andmatcha/nixie_bom/docs/requirements.md

# ニキシー管時計 要件定義

## 1. 目的

IN-12 ニキシー管を 6 本使用し、CAN 経由で受信した時刻を表示する卓上時計を製作する。

時計本体には RTC やバックアップ電池を搭載せず、外部の CAN ノードから配信される時刻データを表示する。

## 2. 前提とスコープ

- 表示対象は時刻表示とする。
- 表示形式は `HH:MM:SS` とする。
- 時刻は 24 時間表記とする。
- 1 桁目のゼロは表示する。例: `08:05:09`
- 数字表示には IN-12 を 6 本使用する。
- コロン表示には INS-1 を 4 個使用する。
- 時分間と分秒間に、それぞれ INS-1 を 2 個ずつ配置する。
- 入力電源は市販 AC アダプタから得られる DC 12 V とする。
- 12 V からニキシー管用の高電圧を基板上で生成する。
- 制御用 MCU は STM32 系を使用する。
- 時刻同期は CAN 経由で行う。
- RTC、GPS、Wi-Fi、単体での時刻保持機能は今回の必須範囲に含めない。

## 3. システム構成

想定する構成は以下の通り。

- DC ジャックから 12 V を入力する。
- TPS40210DGQR を中心とした昇圧回路で約 170 V のニキシー管用電源を生成する。
- STM32 が CAN フレームを受信し、表示すべき時刻を決定する。
- STM32 から SN74HC595DR などのシフトレジスタへ表示データを転送する。
- SN75468DR などのシンクドライバで IN-12 のカソードを駆動する。
- 各管のアノードを切り替える高電圧対応のアノードドライバを用意し、IN-12 はダイナミック点灯で表示する。
- INS-1 はコロン表示用として、電流制限抵抗を介して点灯制御する。
- CAN トランシーバを介して外部 CAN バスに接続する。

## 4. 表示要件

- 6 本の IN-12 で `時:分:秒` を表示する。
- 時分間と分秒間のコロンは、INS-1 を各 2 個使用して表現する。
- 秒表示までリアルタイムに更新する。
- 視認上ちらつきが分からない表示を目標とする。
- IN-12 はダイナミック点灯とし、各管の更新周期は 100 Hz 以上を目標とする。
- 桁切り替え時に短いブランキング期間を設け、ゴースト点灯を抑える。
- IN-12 の平均管電流は 1 管あたり 2 mA から 2.5 mA 程度を初期目標とする。
- ダイナミック点灯時のピーク電流は、平均管電流、デューティ比、IN-12 の許容条件を確認して決める。
- INS-1 の電流は、視認性と寿命を見ながら実機で調整できるようにする。

## 5. 電源要件

### 5.1 入力電源

- 入力電圧は DC 12 V とする。
- 入力電流容量は 1 A 以上の AC アダプタを想定する。
- DC ジャックは 2.1 mm 標準品を使用する。
- 極性はセンタープラスとする。
- 入力段には逆接続、過電流、突入電流への対策を検討する。

### 5.2 高電圧電源

- ニキシー管用の出力電圧は DC 170 V を基準とする。
- 設計上は管の個体差や輝度調整を考慮し、160 V から 180 V 程度の範囲で調整または部品定数変更できる余地を残す。
- 高電圧電源の出力電流目標は 170 V / 20 mA とする。
- 20 mA の出力電流目標には、6 本の IN-12、4 個の INS-1、輝度調整、部品ばらつき、過渡応答の余裕を含める。
- TPS40210DGQR の FB、COMP、SS、ISNS、RC 周辺部品はデータシートの設計手順に従って定数を決める。
- ISNS による過電流検出を使用し、MOSFET、インダクタ、ダイオード、出力コンデンサが異常時に過負荷にならないようにする。
- 起動時の過電圧を避けるため、ソフトスタートを有効にする。
- MCU またはハードウェアから高電圧電源を停止できる HV_ENABLE 相当の制御手段を設ける。
- 高電圧出力には放電抵抗を設け、電源断後に出力コンデンサが安全な電圧まで下がるようにする。
- 高電圧部のテストポイントには明確なシルク表記を入れる。

## 6. 点灯・駆動方式

本プロジェクトでは IN-12 にダイナミック点灯を採用する。

スタティック点灯と比べてカソード配線とドライバ数を大きく削減でき、6 桁時計として基板規模と部品点数を抑えやすいためである。

### 6.1 ダイナミック点灯の要件

- 6 本の IN-12 を順次点灯し、1 巡を十分高速に回す。
- カソード側は数字 0 から 9 の 10 系統を共通化する。
- アノード側は 6 本分を個別に切り替える。
- カソード 10 系統は SN75468DR 2 個以上、または同等の低側シンクドライバで駆動する。
- 表示駆動信号は SN74HC595DR を必要数カスケード接続して生成する。
- シフトレジスタ更新中は表示を一時的に無効化し、誤点灯を防ぐ。
- アノードドライバは 170 V 系を扱える PNP トランジスタ、Pch MOSFET、または高電圧対応の専用/ディスクリート構成で実装する。
- SN75468DR は低側シンク用途に限定し、アノードの高側スイッチには使用しない。
- 6 桁の多重化により平均 2 mA から 2.5 mA 程度の明るさを得られるよう、ピーク電流と電流制限抵抗を決める。

### 6.2 カソードプリバイアス方針

- SN75468DR の出力耐圧が 100 V 級であることを考慮し、消灯状態のカソードは約 85 V にプリバイアスする。170 V から 180 V の高電圧範囲では、無負荷 VPRE が約 85 V から 90 V になる初期定数とする。
- 点灯時は約 170 V の高電圧供給とカソード側のシンク動作により IN-12 を点灯させる。
- SN75468DR の各出力端子に印加される電圧が定格を超えないことを、回路設計と実測の両方で確認する。
- プリバイアス回路は、消灯時に誤点灯しないこと、点灯時に十分な管電流が流れること、電源断時に危険な電荷が残らないことを満たす。

### 6.3 スタティック点灯を採用しない理由

- 6 本 x 10 数字で、少なくとも 60 本分のカソード駆動出力が必要になる。
- シフトレジスタとドライバの個数、配線量、PCB 面積が増える。
- ちらつきやピーク電流設計は簡単になるが、今回の 6 桁時計では回路規模増加のデメリットが大きい。
- 表示品質や制御単純さを最優先する将来版では再検討候補とする。

### 6.4 駆動上の注意

- IN-12 と INS-1 には必ず電流制限抵抗を入れる。
- SN75468DR の COM 端子は誘導性負荷用クランプダイオードに接続されているため、ニキシー管駆動での接続先は安易に 170 V 系へ接続せず、回路方式に合わせて判断する。
- SN74HC595DR は STM32 と同じ 3.3 V ロジックで動作させる方針とし、各 IC の VCC 近傍に 0.1 uF 程度のデカップリングコンデンサを配置する。
- 未使用入力は GND または VCC に固定し、フローティングさせない。

## 7. 制御・通信要件

### 7.1 STM32

- CAN または FDCAN、SPI、タイマ、十分な GPIO、SWD を持つ STM32G0B1/G0C1/G4 系を候補とする。
- 表示更新用のタイマ、シフトレジスタ転送用の SPI または GPIO、CAN 受信用ペリフェラルを使用する。
- 高電圧電源の有効化、異常時停止、表示ブランキングを MCU から制御できるようにする。
- デバッグ用に SWD 端子を用意する。
- ファームウェア更新とデバッグがしやすいよう、リセット端子とブート設定にアクセスできるようにする。

### 7.2 CAN

- CAN 経由で現在時刻を受信し、受信した時刻を表示する。
- 時計本体は時刻の一次ソースを持たない。
- CAN は CAN 2.0B、1 Mbps、標準 ID を基本条件とする。
- 時刻フレームは 1 Hz 以上の周期で送信されるものとする。
- 時刻データは時、分、秒をバイナリで送る単純な形式とする。
- 最小構成では、DLC 3 とし、Byte 0 を時、Byte 1 を分、Byte 2 を秒とする。
- CAN 送信側が表示すべきローカル時刻に変換し、時計側は受信した時、分、秒をそのまま表示する。
- 起動直後、CAN で有効な時刻を受信するまでは表示をブランクまたは待機表示にする。
- 最終受信から 2 秒を超えたら表示をブランクする。
- CAN 途絶が長時間続く場合は、高電圧電源も停止する。初期値として 10 秒超を目安にする。
- CAN トランシーバは STM32 の I/O 電圧と CAN バス仕様に合わせて選定する。
- CAN 終端抵抗 120 ohm は、ジャンパまたは DIP スイッチで有効/無効を切り替えられるようにする。

## 8. 安全・実装要件

- 170 V 系は低電圧ロジック系から物理的に距離を取り、配線領域を分ける。
- 高電圧配線、テストポイント、出力コンデンサ周辺には警告シルクを入れる。
- ユーザーが触れる可能性のある部分に高電圧が露出しない構造にする。
- 初回基板でも高電圧部に触れられない構造を必須とする。
- 最終ケース設計は別工程に分ける。
- 高電圧部の部品は、電圧定格、電力定格、温度上昇に十分な余裕を持たせる。
- 出力コンデンサ、帰還抵抗、電流制限抵抗、プリバイアス抵抗は電圧定格と消費電力を確認する。
- CAN、12 V 入力、170 V 出力、GND、HV_ENABLE には確認しやすいテストポイントを設ける。
- 初回通電時はニキシー管を接続せず、ダミーロードで 170 V 出力、リップル、過電流保護、部品温度を確認する。

## 9. 検証要件

- 12 V 入力で高電圧出力が目標値に立ち上がることを確認する。
- 無負荷、ダミーロード、実負荷の各条件で高電圧出力が安定することを確認する。
- 170 V / 20 mA 相当の負荷で、入力電流が 12 V / 1 A の範囲に収まることを確認する。
- MOSFET、インダクタ、ダイオード、出力コンデンサ、電流制限抵抗、プリバイアス抵抗の温度上昇を確認する。
- IN-12 の平均管電流が 2 mA から 2.5 mA 程度になることを確認する。
- ダイナミック点灯で、ちらつき、ゴースト、輝度ムラが許容範囲に収まることを確認する。
- SN75468DR の出力端子電圧が、点灯時、消灯時、切り替え時の各条件で定格内に収まることを確認する。
- INS-1 の明るさが IN-12 表示と大きく乖離しないことを確認する。
- CAN 受信正常時に時刻表示が 1 秒ごとに更新されることを確認する。
- CAN 途絶 2 秒超で表示がブランクすることを確認する。
- CAN 途絶が長時間続いた場合に高電圧電源が停止することを確認する。
- 電源断後、高電圧出力が放電抵抗により安全側へ低下することを確認する。

## 10. 選定済み部品

### 10.1 電源系

| 型番 | 用途 | 要件上の扱い |
| --- | --- | --- |
| TPS40210DGQR | 昇圧コントローラ | 12 V から 170 V を生成する高電圧電源の中心部品 |
| 7447709102 | インダクタ 1 mH / 900 mA | 昇圧回路用。飽和電流、温度上昇、DCR を実負荷で確認する |
| STD10N60M2 | 600 V Nch MOSFET | 昇圧スイッチ用。VDS、ID、発熱、ゲート駆動条件を確認する |
| STTH2R06U | 600 V / 2 A ダイオード | 昇圧整流用。逆回復、順方向損失、発熱、電圧定格を確認する |
| GRM55DR72E105KW01L | 1 uF / 250 V セラミックコンデンサ | 高電圧出力平滑用。DC バイアス、リップル、並列数を確認する |
| GRM188R72A104KA35D | 0.1 uF / 100 V セラミックコンデンサ | 制御・補助回路用。配置と定格を回路ごとに確認する |
| GCM188R71H102KA37D | 1000 pF / 50 V セラミックコンデンサ | 補償・フィルタ用途候補。使用箇所に応じて定数を確定する |
| ERJ-8BSFR10V | 0.1 ohm / 1% / 1/2 W 抵抗 | 電流検出用途候補。TPS40210 の電流制限条件と整合を確認する |

### 10.2 制御・表示駆動系

| 型番 | 用途 | 要件上の扱い |
| --- | --- | --- |
| STM32G0B1CBT6 | 制御 MCU | CAN 受信、表示更新、HV_ENABLE、ブランキング、SWD デバッグを担当する |
| AP63203QWU-7 | 3.3 V 降圧レギュレータ | 12 V から MCU、CAN、ロジック用の 3.3 V を生成する |
| 74439346068 | 6.8 uH インダクタ | AP63203QWU-7 の降圧回路用 |
| TCAN334GDR | CAN トランシーバ | 3.3 V 単電源の CAN 物理層。1 Mbps の CAN 2.0B で使用する |
| ESD2CAN24DBZRQ1 | CAN ESD 保護 | CANH/CANL の外部接続保護用 |
| ECS-80-12-33-JGN-TR | 8 MHz 水晶振動子 | CAN ビットタイミングの安定化を目的に MCU の HSE として使用する |
| SN75468DR | 7ch Darlington シンクドライバ | 2 個使用し、10 本の IN-12 カソードを駆動する。プリバイアス方式で出力端子電圧を 100 V 級に抑える |
| SN74HC595DR | 8bit シフトレジスタ | 3 個使用し、カソード、アノード、INS-1 制御信号を生成する |
| MMBTA92-7-F | 300 V PNP トランジスタ | IN-12 アノード高側スイッチ用 |
| MMBTA42-7-F | 300 V NPN トランジスタ | IN-12 アノードドライバのレベルシフト、および INS-1 低側スイッチ用 |
| INS-1 | ネオンランプ | コロン表示用。時分間と分秒間に 2 個ずつ、合計 4 個使用する |

## 11. 未確定要件

現時点で、要件としての未確定項目はない。

以下は要件ではなく、詳細設計または部品選定で確定する項目とする。

- STM32G0B1CBT6 の具体的なピン割り当て
- SN74HC595DR のビット割り当て
- IN-12、INS-1、プリバイアス回路の抵抗値の実機調整
- TPS40210DGQR 周辺の帰還、補償、ソフトスタート、電流検出、発振周波数設定の定数
- PCB 上の高電圧クリアランス、テストポイント配置、警告シルク
- 最終ケース構造
