andmatcha/nixie_bom/selection_criteria.md

# 部品選定基準

## プロジェクト概要

- プロジェクト名: nixie_bom
- 用途: IN-12 ニキシー管 6 本と INS-1 4 個を使う CAN 同期式ニキシー管時計
- 入力電源: DC 12 V、1 A 以上の AC アダプタを想定
- 主要機能: 12 V から約 170 V を生成し、STM32 が CAN 経由で受信した時刻を HH:MM:SS で表示する
- 詳細要件の参照先: `docs/requirements.md`

## 必須条件

- Digi-Key で通常在庫かつ即時入手可能な部品を優先する。
- アクティブ品を採用し、EOL、Obsolete、Discontinued、NCNR、Marketplace のみの部品は避ける。
- RoHS 対応品を優先する。
- データシートが取得できる部品を採用する。
- 高電圧系は 170 V から 180 V の動作範囲と異常時余裕を考慮し、電圧定格と電力定格に十分な余裕を持たせる。
- 3.3 V ロジック系は STM32、CAN トランシーバ、SN74HC595DR と整合する部品を選ぶ。
- CAN は CAN 2.0B、1 Mbps を前提にする。
- CAN 終端、ESD 保護、SWD、リセット、HV_ENABLE、ブランキング制御に必要な部品を含める。

## 推奨条件

- コンデンサは Murata 品を優先する。
- 抵抗は Panasonic 品を優先する。
- 0603、0805、1206、1210 など手実装と基板面積のバランスが取りやすいパッケージを優先する。
- Digi-Key のカットテープ品で少量試作しやすい部品を優先する。
- 代替品選定時は元の値、定格、温度特性、パッケージを維持する。

## 評価観点

- 12 V 入力、170 V / 20 mA 高電圧出力、6 桁ダイナミック点灯で電気的余裕があること。
- MOSFET、インダクタ、ダイオード、電流検出抵抗、放電抵抗、プリバイアス抵抗の発熱余裕があること。
- SN75468DR の出力端子電圧が 100 V 級の定格内に収まるプリバイアス構成に合うこと。
- CAN 1 Mbps で通信品質を確保できること。
- 試作時に入手しやすく、将来の置き換え候補も見つけやすいこと。

## 除外条件

- EOL、Obsolete、Discontinued、NCNR の部品。
- Marketplace のみ、在庫 0、最小注文数量が試作規模に対して過大な部品。
- データシートがない部品。
- 高電圧部で電圧定格または電力定格の余裕が不足する部品。
- 要件上の用途と矛盾する部品。例: SN75468DR を高側アノードスイッチとして使う構成。

## BOM運用メモ

- DB 管理 BOM は `data/digikey/parts.sqlite3` の `bom_items` を正とする。
- `bom/bom.csv` は `dktools` が DB から出力する確認用スナップショットとして扱う。
- 既存の統合 BOM 入力は `bom/nixie_clock_integrated_digikey_bom_active.csv` を参照する。
- Digi-Key アップロード用 CSV は必要時に `dktools bom export-digikey` で生成する。
- 価格再取得と部品ストア更新は必要時に `dktools bom price` と `dktools store update --from-bom` で行う。

## 未確定事項

- STM32 の具体的なピン割り当て。
- SN74HC595DR のビット割り当て。
- IN-12、INS-1、プリバイアス回路の抵抗値。
- TPS40210DGQR 周辺の帰還、補償、ソフトスタート、電流検出、発振周波数設定の最終定数。
- PCB 上の高電圧クリアランス、テストポイント配置、警告シルク。
- 最終ケース構造。
