andmatcha/nixie_bom/docs/kicad_library_gaps.md

# KiCad ライブラリ未確定・要レビュー部品

標準ライブラリまたは生成ライブラリで回路図への配置は済ませたが、下記はメーカー専用品、近似フットプリント、またはピン/機械寸法の確認が必要な部品である。

| Ref | MPN | Selected Symbol | Selected Footprint | Issue | Next Action |
| --- | --- | --- | --- | --- | --- |
| - | - | - | - | 未確定または取得不能な部品はなし | - |
