andmatcha/nixie_bom/docs/digikey_availability.md

# Digi-Key 可用性チェック

`bom/nixie_clock_integrated_digikey_bom_active.csv` の各明細について、Digi-Key 上でアクティブ、在庫あり、即時入手可能かを確認した。

| 項目 | 値 |
| --- | ---: |
| 対象明細数 | 46 |
| 即時入手可能 | 46 |
| 要確認 | 0 |
| 判定 | OK |

確認日時: 2026-06-22 21:01:42 JST
出力 CSV: `bom/nixie_clock_active_digikey_availability.csv`

## 要確認明細

| Reference Designator | Manufacturer Part Number | Status | Quantity Available | 理由 |
| --- | --- | --- | ---: | --- |
| なし | なし | なし | なし | なし |
