andmatcha/nixie_bom/docs/digikey_replacements.md

# Digi-Key 代替品選定

在庫 0、Digi-Key ステータスが新規設計向けに不適合、または安全余裕改善のため置換した BOM 明細について、代替品を選定した。

出力 BOM: `bom/nixie_clock_integrated_digikey_bom_active.csv`

| Reference Designator | 旧型番 | 新型番 | 新 Digi-Key 品番 | Status | 在庫 | 主な仕様 | 理由 |
| --- | --- | --- | --- | --- | ---: | --- | --- |
| CRC1 | GRM1885C1H101JA01D | GCM1885C1H101JA16D | 490-4767-1-ND | アクティブ | 2080401 | 静電容量: 100 pF; 許容誤差: ±5%; 電圧 - 定格: 50V; 温度係数: C0G、NP0; パッケージ/ケース: 0603（1608メートル法） | 旧品はDigi-Keyステータスが新規設計向けに不適合。CRCは100pF、50V、C0G/NP0、0603を維持し、アクティブかつ在庫あり。 |
| CIFLT1 | GCM1885C1H101JA16D | GCM1885C1H471JA16D | 490-4965-1-ND | アクティブ | 28260 | 静電容量: 470 pF; 許容誤差: ±5%; 電圧 - 定格: 50V; 温度係数: C0G、NP0; パッケージ/ケース: 0603（1608メートル法） | TPS40210のISNSフィルタ時定数をデータシート目安へ近づけるため、100pFから470pFへ変更。 |
| D1 | MURS160-13-F | STTH2R06U | 497-3776-1-ND | アクティブ | 16670 | 電圧 - DC逆方向: 600 V; 電流 - 平均整流: 2A; 逆回復時間: 50 ns; パッケージ/ケース: DO-214AA、SMB | 同じ600 V/SMB/trr 50 nsを維持しつつ、平均整流電流を1 Aから2 Aへ増やして安全余裕を改善する。 |
| CHF1 | GCM1885C1H470JA16D | GCM1885C1H470GA16J | 490-GCM1885C1H470GA16JCT-ND | アクティブ | 7433 | 静電容量: 47 pF; 許容誤差: ±2%; 電圧 - 定格: 50V; 温度係数: C0G、NP0; パッケージ/ケース: 0603（1608メートル法） | 旧品はDigi-Keyステータスが新規設計向けに不適合。47pF、50V、C0G/NP0、0603を維持し、許容差はより厳しく、アクティブかつ在庫あり。 |
| RIFLT1 REN1 | ERJ-3EKF1001V | ERJ-3GEYJ102V | P1.0KGCT-ND | アクティブ | 26489 | 抵抗: 1 kOhms; 許容誤差: ±5%; 温度係数: ±200ppm/°C; パッケージ/ケース: 0603（1608メートル法）; 電力（ワット）: 0.1W、1/10W; 組成: 厚膜 | 旧品はDigi-Key在庫0。今回の抵抗メーカー指定に合わせ、ISNSフィルタ/DIS-EN直列用途で許容できるPanasonic在庫品を採用。 |
| C3V3IN1 C3V3IN2 | GRM31CR71H475KA12L | GRJ31CR71H475KE11K | 490-GRJ31CR71H475KE11KCT-ND | アクティブ | 5980 | 静電容量: 4.7 µF; 許容誤差: ±10%; 電圧 - 定格: 50V; 温度係数: X7R; パッケージ/ケース: 1206（3216メートル法） | 旧品はDigi-Key在庫0。4.7uF、50V、X7R、1206を維持し、アクティブかつ在庫あり。 |
| C3V3OUT1 C3V3OUT2 | GRT31CR61E226ME01L | GRM31CC81E226KE11L | 490-14468-1-ND | アクティブ | 58999 | 静電容量: 22 µF; 許容誤差: ±10%; 電圧 - 定格: 25V; 温度係数: X6S; パッケージ/ケース: 1206（3216メートル法） | 旧品はDigi-Keyステータスが新規設計向けに不適合。22uF、25V、1206を維持し、今回のコンデンサメーカー指定に合わせてMurata在庫品を採用。 |
| CY1 CY2 | GRM1885C1H180JA01D | GCM1885C1H180FA16D | 490-GCM1885C1H180FA16DCT-ND | アクティブ | 1302 | 静電容量: 18 pF; 許容誤差: ±1%; 電圧 - 定格: 50V; 温度係数: C0G、NP0; パッケージ/ケース: 0603（1608メートル法） | 旧品はDigi-Keyステータスが新規設計向けに不適合。18pF、50V、C0G/NP0、0603を維持し、許容差はより厳しく、アクティブかつ在庫あり。 |
| RAHOFF1A-RAHOFF6B | ERJ-6ENF1004V 単体/桁 | ERJ-6ENF4993V x 2/桁 | P499KCCT-ND | アクティブ | 197025 | 抵抗: 499 kOhms; 許容誤差: ±1%; 電力: 0.125W; パッケージ/ケース: 0805（2012メートル法） | PNP オン時に 170 V 系の電位差を受けるため、1 MOhm 単体ではなく 499 kOhm x 2 直列として抵抗 1 本あたりの印加電圧を約 85 V へ分散する。 |
| RPREH1 | ERJ-6ENF1503V | ERJ-6ENF1803V | P180KCCT-ND | アクティブ | 29682 | 抵抗: 180 kOhms; 許容誤差: ±1%; 電力: 0.125W; パッケージ/ケース: 0805（2012メートル法） | VPRE を 170 V 時約 85.0 V、180 V 時約 90.0 V へ下げ、SN75468 の 100 V 出力耐圧に対する静的余裕を増やす。 |

## 選定ルール

- 元の値、定格、サイズ、温度特性を維持することを優先した。
- 今回の指定に合わせ、コンデンサはMurata、抵抗はPanasonicを優先した。
- 選定後に Digi-Key ProductDetails を再取得し、`アクティブ`、必要数量以上の在庫、即時入手可能を確認した。
