andmatcha/nixie_bom/docs/tps40210_datasheet_summary.md

# データシート要約: Texas Instruments TPS40210DGQR

## 1. 部品概要

| 項目 | 内容 |
| --- | --- |
| メーカー | Texas Instruments |
| 型番 | TPS40210DGQR |
| 部品カテゴリ | 電源IC・DC/DCコントローラ |
| 主用途 | 非同期昇圧、フライバック、SEPIC、LEDドライバ向けの電流モード低側Nch MOSFETコントローラ |
| このプロジェクトでの役割 | DC 12 VからIN-12/INS-1用の約170 V / 20 mAを生成する昇圧電源コントローラ |
| パッケージ | HVSSOP, DGQ, 10ピン, PowerPAD |
| データシート版・日付 | SLUS772G, March 2008, Revised June 2020 |
| 参照PDF | docs/tps40210.pdf |

## 2. 結論サマリ

- 採用可否: 条件付きで採用可能
- 主な理由: 12 V入力は推奨VDD範囲内で、外付けMOSFET方式の昇圧構成に適合する。170 V出力はIC端子に直接印加せず、外付けMOSFET、ダイオード、出力コンデンサ、帰還抵抗の定格で成立させる設計であれば使用できる。
- 設計上もっとも重要な制約: 高昇圧比による高デューティ動作、最小オフ時間、電流検出抵抗と内部スロープ補償の上限、起動時の出力コンデンサ充電電流、標準昇圧回路では出力短絡時に入力から出力へ電流経路が残ること。
- 実機で必ず確認する項目: 10.8 V入力時の起動、170 V / 20 mA負荷時のSW波形、ISNS波形、出力リップル、COMP安定性、起動時過電流、CAN途絶時DIS/EN停止、電源断後の放電、MOSFET/インダクタ/ダイオード温度。
- 未確認リスク: 外付け部品それぞれの詳細データシートに基づく熱、飽和、逆回復、DCバイアス、抵抗電圧定格は別途確認が必要。

## 3. 重要仕様一覧

| 項目 | 値 | Min/Typ/Max | 条件 | 参照箇所 | 設計上の意味 |
| --- | --- | --- | --- | --- | --- |
| VDD推奨動作範囲 | 4.5 Vから52 V | Min/Max | Recommended Operating Conditions | p.4, 6.3 | 12 V入力駆動は範囲内。170 V出力へVDDを接続してはいけない。 |
| VDD絶対最大定格 | -0.3 Vから52 V | Min/Max | Absolute Maximum Ratings | p.4, 6.1 | VDDは52 Vを超えない設計が必須。 |
| RC, SS, FB, DIS/EN絶対最大定格 | -0.3 Vから10 V | Min/Max | Absolute Maximum Ratings | p.4, 6.1 | FB分圧、DIS/EN制御、RC/SS部品は低電圧ノードとして扱う。 |
| ISNS絶対最大定格 | -0.3 Vから8 V | Min/Max | Absolute Maximum Ratings | p.4, 6.1 | 電流検出ノードのスパイクを抑える。 |
| COMP, BP, GDRV絶対最大定格 | -0.3 Vから9 V | Min/Max | Absolute Maximum Ratings | p.4, 6.1 | ゲート駆動はBP由来の約8 V系。 |
| 動作ジャンクション温度 | -40 degCから125 degC | Min/Max | Recommended Operating Conditions | p.4, 6.3 | 実機でIC周辺温度を確認する。 |
| HVSSOP熱抵抗RthetaJA | 67.2 degC/W | Typ相当 | Thermal Information, TPS40210 HVSSOP | p.4, 6.4 | BP外部負荷やゲート駆動損失を増やしすぎない。 |
| FB基準電圧, TPS40210 | 686 mV / 700 mV / 714 mV | Min/Typ/Max | 4.5 V <= VDD <= 52 V, -40 degC <= TJ <= 125 degC | p.5, 6.5 | 出力設定と出力電圧許容範囲の基準。 |
| UVLOオンしきい値 | 4.00 V / 4.25 V / 4.50 V | Min/Typ/Max | VDD rising | p.5, 6.5 | 12 V入力では十分余裕あり。 |
| UVLOヒステリシス | 140 mV / 195 mV / 240 mV | Min/Typ/Max | VDD | p.5, 6.5 | 低入力時の起動停止挙動に影響。 |
| 発振周波数範囲 | 35 kHzから1000 kHz | Min/Max | Oscillator | p.5, 6.5 | 約168 kHz設定は範囲内。 |
| 推奨RC範囲 | CT 68 pFから120 pF、RT 100 kOhmから1 MOhm | 推奨 | Setting the Oscillator Frequency | p.16, 7.3.5 | CRC=100 pF、RRC=1 MOhmは範囲内だがRRCは上限値。 |
| 最小オン時間 | 275 ns typ, 400 ns max | Typ/Max | VDD=12 V | p.5, 6.5 | 今回のオン時間約5.5 usに対して十分余裕。 |
| 最小オフ時間 | 170 ns typ, 200 ns max | Typ/Max | PWM | p.5, 6.5 | 10.8 V入力時のオフ時間約376 nsで余裕あり。 |
| 過電流検出しきい値 | 120 mV / 150 mV / 180 mV | Min/Typ/Max | 4.5 V <= VDD < 52 V, -40 degC <= TJ <= 125 degC | p.5, 6.5 | RSNSとインダクタ飽和電流の組み合わせ確認が必要。 |
| Leading edge blanking | 75 ns | Typ | Overcurrent protection | p.5, 6.5 | ISNSスパイクの短時間マスク。 |
| 電流センスアンプゲイン | 4.2 V/V / 5.6 V/V / 7.2 V/V | Min/Typ/Max | Current Sense Amplifier | p.5-p.6, 6.5 | スロープ補償計算に関係。 |
| GDRVソース電流 | 375 mA / 400 mA | Min/Typ | VGDRV=4 V, TJ=25 degC | p.6, 6.5 | 外付けMOSFETのゲート電荷とスイッチング損失を確認する。 |
| GDRVシンク電流 | 330 mA / 400 mA | Min/Typ | VGDRV=4 V, TJ=25 degC | p.6, 6.5 | ゲート抵抗とターンオフ速度に関係。 |
| BP電圧 | 7 V / 8 V / 9 V | Min/Typ/Max | 0 mA < IBP < 15 mA | p.6, 6.5 | BPには1 uFを近接配置する。外部負荷を安易に接続しない。 |
| DIS/ENしきい値 | 0.7 Vから1.3 V | Min/Max | Turn-on voltage | p.6, 6.5 | ピンを高くすると停止、低いまたは未接続で有効。3.3 V MCUで停止制御可能。 |
| DIS内部プルダウン | 0.7 MOhm / 1.1 MOhm / 1.5 MOhm | Min/Typ/Max | DIS/EN | p.6, 6.5 | 未接続では有効になる。安全停止が必要なら外部プルダウン/制御論理を明確化する。 |
| ESD耐量 | HBM +/-1500 V, CDM +/-1500 V | Value | ESD Ratings | p.4, 6.2 | 通常のESD管理を前提に実装する。 |
| TPS40210DGQR状態 | Active, Production, RoHS Yes, MSL Level-1-260C-UNLIM | 表記値 | Mechanical, Packaging, and Orderable Information | p.45, Orderable table, 9-Nov-2025 | ローカルPDF上ではTPS40210DGQRは量産中扱い。 |

## 4. カテゴリ別確認事項

### 4.1 電源IC・DC/DCコントローラ

- 入力電圧範囲: データシート推奨はVDD 4.5 Vから52 V。今回の12 V nominal、10.8 Vから13.2 V確認範囲は適合する。
- FB基準電圧: TPS40210は700 mV typ、全温度範囲で686 mVから714 mV。
- スイッチング周波数: 35 kHzから1000 kHz。外付けRT/CTで設定する。
- 最小オン/オフ時間: VDD=12 Vで最小オン時間400 ns max、最小オフ時間200 ns max。
- 電流検出: ISNSが過電流しきい値を超えるとヒカップ動作に入り、SSコンデンサで再試行時間が決まる。
- ゲートドライブ: 内蔵400 mA級低側ゲートドライバ。Nch MOSFETのソースをGND基準で使う構成に適合する。
- BPレギュレータ: 約8 V出力。1 uFバイパスが必須。外部負荷を接続する場合はIC損失を確認する。
- DIS/EN: 高レベルでシャットダウン、低レベルまたは未接続で有効。シャットダウン時はBPレギュレータも停止する。
- レイアウト: VDD/BP/ISNS/RC/FB/COMP/SS周辺をIC近傍に置き、SWノードと大電流ループを小さくする。
- 異常時: 標準昇圧トポロジでは出力短絡時に入力からインダクタとダイオード経由で出力へ電流が流れるため、必要に応じてヒューズなど二次保護が必要。

## 5. ピン・端子情報

| ピン名 | 役割 | 推奨接続 | 禁止・注意事項 | 参照箇所 |
| --- | --- | --- | --- | --- |
| RC | 発振周波数設定 | RCからVDDへ抵抗、RCからGNDへコンデンサ | 100 kOhmから1 MOhm、68 pFから120 pFが扱いやすい。同期時以外は不要なノイズを入れない。 | p.3, Pin Functions; p.16, 7.3.5 |
| SS | ソフトスタート、過電流再試行タイマ | SSからGNDへコンデンサ | 起動時のCOUT充電電流が過電流しきい値を超えないようにする。 | p.3, Pin Functions; p.12-p.14, 7.3.1 |
| DIS/EN | シャットダウン入力 | MCU制御、未使用時はGND推奨 | 高レベルで停止、未接続では内部プルダウンにより有効。HV_ENABLEの論理を取り違えない。 | p.3, Pin Functions; p.15, 7.3.3; p.24, 7.4.2 |
| COMP | エラーアンプ出力 | COMP-FB間に補償ネットワーク | SW/ISNSの高dv/dtノイズから離す。 | p.3, Pin Functions; p.21-p.23, 7.3.10 |
| FB | 帰還入力 | VOUTからGNDへの分圧中点 | FB端子自体は10 V abs max。170 Vは上側抵抗列だけに印加する。 | p.3, Pin Functions; p.29-p.31, 8.2.1.2.10 |
| GND | ICグラウンド | 電流検出抵抗のGND側と低ノイズに接続 | 大電流ループの戻りと小信号GNDの取り回しに注意。 | p.3, Pin Functions; p.37, 10.1 |
| ISNS | 電流検出入力 | MOSFETソース電流検出抵抗からRIFLT/CIFLT経由で接続 | 過電流しきい値は120 mVから180 mV。フィルタ部品はISNS/GND近傍。 | p.3, Pin Functions; p.18-p.20, 7.3.7から7.3.9 |
| GDRV | 外付けNch MOSFETゲート駆動 | ゲート抵抗を介してMOSFETゲートへ | トレースと戻り経路の寄生を小さくする。 | p.3, Pin Functions; p.23, 7.3.11; p.37, 10.1 |
| BP | 内部レギュレータ出力 | BP-GND間に1 uFを近接配置 | 外部負荷を接続する場合はTPS40210の熱を確認。シャットダウン時は停止。 | p.3, Pin Functions; p.14-p.15, 7.3.2 |
| VDD | IC入力電源 | 12 V入力へ接続し、近接バイパスを置く | VDD abs maxは52 V。今回の170 V出力へ接続不可。 | p.3, Pin Functions; p.4, 6.1; p.36, 9 |

## 6. 外付け部品・周辺回路

| 部品 | 接続先 | 役割 | 推奨値・式 | 今回の設計での扱い |
| --- | --- | --- | --- | --- |
| RRC, CRC | RC, VDD, GND | 発振周波数設定 | Eq.14。CTは68 pFから120 pF、RTは100 kOhmから1 MOhm推奨。 | 100 pF + 1.00 MOhmで約168 kHz。OK。ただしRRCは推奨上限。 |
| CSS | SS-GND | ソフトスタート、過電流再試行タイマ | Eq.1からEq.6。VDD > 8 Vでは例としてCSS = 20 x TSS x 10^-6。 | 1 uFへ増量済み。20 mA負荷付き起動を見込む。 |
| RIFLT, CIFLT | 電流検出抵抗からISNS | ISNSノイズフィルタ | RIFLTは1 kOhmから5 kOhm程度、RIFLT x CIFLT = 0.1 x tON。 | 1 kOhm + 470 pFへ変更済み。今回条件の目安約0.55 usに対して0.47 us。 |
| RSNS | MOSFETソース-GND | 電流モード制御、過電流検出 | Eq.15, Eq.16, Eq.19。過電流とスロープ補償の両方で上限を決める。 | L1維持前提で0.15 Ohmへ変更済み。Eq.19の80 %目安に収めつつ過電流点を下げる。 |
| FB分圧抵抗 | VOUT-FB-GND | 出力電圧設定 | 上側抵抗は10 kOhmから100 kOhmの範囲が目安。 | 上側合計100 kOhm、下側412 Ohmで約170.6 V。OK。 |
| COMP補償 | COMP-FB | ループ補償 | Eq.22からEq.29。実測またはWEBENCH/Spiceで確認推奨。 | 68 kOhm, 2200 pF, 47 pFは初期値として妥当。実機で要調整。 |
| ゲート抵抗 | GDRV-MOSFETゲート | リンギング、ジッタ、EMI低減 | Eq.30, RG = 105 / QG。QGは8 V VGS時のnC。 | 10.2 Ohmは保守的。MOSFETのQGと発熱で要確認。 |
| BPバイパス | BP-GND | 内部8 Vレギュレータ安定化 | 1 uF必須。 | CBP1=1 uFでOK。IC近傍に配置する。 |
| VDDバイパス | VDD-GND | 入力高周波デカップリング | 近接配置。入力源が離れる場合は追加バルク容量が必要になり得る。 | CVDD1=1 uFはOK。12 V入力にはCINB1/CINB2として22 uF x2を追加済み。 |
| 出力短絡保護 | 入力または高電圧出力 | 昇圧回路の短絡保護 | 標準昇圧では入力から出力へ電流経路が残る。 | 初期試作では12 V入力側にFHV1を追加し、将来eFuseやHV側保護を検討する。 |

## 7. 設計式と今回条件への適用

### 7.1 デューティ比と最小オフ時間

- 式: CCMでは D = 1 - VIN / (VOUT + VD)
- データシート上の制約: TPS40210の最小オフ時間は200 ns max、最小オン時間は400 ns max。
- 今回の設計条件: VIN = 10.8 Vから13.2 V、VOUT = 170 V、VD = 1 V、fSW = 約167.9 kHz。
- 計算結果:

| VIN | Duty | tON | tOFF |
| ---: | ---: | ---: | ---: |
| 10.8 V | 93.68 % | 5.58 us | 376 ns |
| 12.0 V | 92.98 % | 5.54 us | 418 ns |
| 13.2 V | 92.28 % | 5.50 us | 460 ns |

- 設計上の注意: 最悪側の10.8 V入力でもtOFFは200 ns maxを上回る。周波数を大きく上げると余裕が減る。

### 7.2 発振周波数

- 式: データシートEq.14でRTをfSWとCTから求める。
- 変数: RTはkOhm、fSWはkHz、CTはpF。
- 今回の設計条件: CRC = 100 pF、RRC = 1.00 MOhm。
- 計算結果: fSW = 約167.9 kHz。
- 設計上の注意: RRCはデータシート推奨範囲の上限。許容差と温度で周波数は変動するが、最小オフ時間にはまだ余裕がある。

### 7.3 インダクタ電流

- 式: IRIPPLE = VIN x D / (L x fSW)、ILavg = IOUT / (1 - D)、ILpeak = ILavg + IRIPPLE / 2。
- 今回の設計条件: L = 1 mH、IOUT = 20 mA。
- 計算結果:

| VIN | IRIPPLE | ILavg | ILpeak | ILrms | IOUT(crit) |
| ---: | ---: | ---: | ---: | ---: | ---: |
| 10.8 V | 60 mA p-p | 317 mA | 347 mA | 317 mA | 1.9 mA |
| 12.0 V | 66 mA p-p | 285 mA | 318 mA | 286 mA | 2.3 mA |
| 13.2 V | 73 mA p-p | 259 mA | 295 mA | 260 mA | 2.8 mA |

- 設計上の注意: 20 mA負荷ではCCM。通常動作電流に対してL1の900 mA/1 A級定格は余裕があるが、過電流しきい値まで含めると別途確認が必要。

### 7.4 電流検出抵抗と過電流

- 式: CCMではデータシートEq.16。スロープ補償上限はEq.19。
- データシート上の制約: VISNS(oc) = 120 mV min, 150 mV typ, 180 mV max。高デューティCCMではRISNSをEq.19の80 %以下にすることが開始点として推奨される。
- 今回の設計条件: L1は7447709102を維持し、RSNS = 0.15 Ohm、L = 1 mH、fSW = 約167.9 kHz。
- 計算結果:

| 項目 | 計算値 |
| --- | ---: |
| VIN=10.8 VでのRISNS(max), Eq.19 | 0.189 Ohm |
| 上記の80 % | 0.151 Ohm |
| 採用RSNS | 0.150 Ohm |
| VISNS=120 mV時の概算ピーク検出電流 | 0.80 A |
| VISNS=150 mV時の概算ピーク検出電流 | 1.00 A |
| VISNS=180 mV時の概算ピーク検出電流 | 1.20 A |
| VIN=10.8 V時の出力過電流目安 | 約49 mA / 61 mA / 74 mA |

- 設計上の注意: 0.15 OhmはEq.19の80 %目安にほぼ一致する。通常動作ピーク約0.35 Aに対しては余裕があり、20 mA負荷の起動条件にも余裕を作れる。一方、VISNS最大側ではピーク検出電流が1.2 A相当となり、L1のIsat 1 Aを超え得るため、実機波形と入力側ヒューズの時間電流特性を確認する。

### 7.5 ISNSフィルタ

- 式: tON = D / fSW、RIFLT x CIFLT = 0.1 x tON。
- 今回の設計条件: RIFLT = 1 kOhm、CIFLT = 470 pF。
- 計算結果: tONは約5.5 us、推奨時定数は約0.55 us。採用値は1 kOhm x 470 pF = 0.47 us。
- 設計上の注意: データシート式の目安に近づいたため、100 pF時よりISNSスパイク耐性が上がる。電流制限応答を過度に遅らせないため、SW波形とISNS波形で誤検出と遅延を確認する。

### 7.6 ソフトスタート

- 式: データシートEq.1。VDD > 8 Vの設計例ではCSS = 20 x TSS x 10^-6。
- 今回の設計条件: CSS = 1 uF、BP = 約8 V。
- 計算結果: RSS(chg)の範囲を含めるとtSSは約32 msから60 ms。typ近傍では約43 ms。
- 設計上の注意: COUT = 3 uF nominalを170 Vまで充電する電流は最短tSS側でも約16 mA程度となる。起動中に20 mA負荷も同時にかかる条件では合計約36 mAとなり、RSNS = 0.15 OhmのVIN=10.8 V最小側出力過電流目安約49 mAを下回る。実際はMLCC実効容量、補償応答、負荷の非線形性で変わるため、20 mA負荷付き起動は実測確認する。

### 7.7 出力コンデンサ

- 式: データシート設計例のEq.45では COUT = 8 x IOUT x D / (VOUT(ripple) x fSW)。
- 今回の設計条件: IOUT = 20 mA、Dmax = 93.68 %、fSW = 約167.9 kHz。
- 計算結果: 1 Vリップル目標なら約0.89 uF、0.5 Vリップル目標なら約1.79 uF。
- 設計上の注意: COUT 1 uF / 250 V x 3はnominalでは十分。ただしX7R MLCCは170 V DCバイアスで実効容量が低下するため、実機リップル測定またはMurata特性確認が必要。

### 7.8 入力コンデンサ

- 式: データシート設計例のEq.47では CIN > IRIPPLE / (4 x VIN(ripple) x fSW)。
- 今回の設計条件: IRIPPLE最大約73 mA p-p。
- 計算結果: VINリップル60 mV目標では約1.5 uF以上。
- 採用値: CIN 10 uF x2に加え、入力バルクとしてCINB 22 uF x2を追加する。
- 設計上の注意: 容量計算上はCIN 10 uF x2だけでも足りるが、データシート9章は入力源が数インチ以上離れる場合に追加バルク容量が必要になり得るとしている。ACアダプタ入力と配線インピーダンスを見込み、Murata MLCCの22 uF x2を追加する。実容量はDCバイアスで低下するため、起動時VINリップルを実測する。

### 7.9 FB分圧

- 式: VOUT = VFB x (1 + Rtop / Rbottom)。
- 今回の設計条件: Rtop = 20 kOhm x 5 = 100 kOhm、Rbottom = 412 Ohm。
- 計算結果:

| VFB条件 | VOUT |
| --- | ---: |
| 686 mV min | 167.2 V |
| 700 mV typ | 170.6 V |
| 714 mV max | 174.0 V |

- 設計上の注意: 抵抗許容差を除いた範囲は160 Vから180 Vの調整余地内。上側100 kOhmはデータシート推奨の上限。分圧電流は約1.69 mA、上側抵抗合計の損失は約0.29 W、20 kOhm 1本あたり約57 mW。

### 7.10 補償回路

- 式: データシートEq.22からEq.29で初期値を求め、最終的には周波数応答測定または過渡応答で確認する。
- 今回の設計条件: RCOMP = 68 kOhm、CCOMP = 2200 pF、CHF = 47 pF。
- 計算結果: ゼロは約1.06 kHz、RCOMPとCHFの高周波ポールは約49.8 kHz。
- 設計上の注意: fSWの10 %は約16.8 kHzであり、初期値としては極端ではない。ニキシー管のダイナミック負荷、無負荷、20 mA負荷で安定性を確認する。

### 7.11 MOSFET、ダイオード、ゲート抵抗

- 式: ダイオード耐圧はデータシート設計例のEq.41で VBR >= VOUT / 0.8。ゲート抵抗はEq.30で RG = 105 / QG。
- 今回の設計条件: VOUT = 170 V。
- 計算結果: ダイオードおよびMOSFETの耐圧目安は最低約213 V以上。600 V品のSTD10N60M2とSTTH2R06Uは耐圧面で十分余裕がある。
- 設計上の注意: QG、逆回復、スイッチング損失、発熱は各外付け部品データシートと実測で確認する。

## 8. レイアウト・実装上の注意

- 電源・GND: VDDバイパスはVDDピン近傍。BPの1 uFはBP/GNDピン近傍。
- 大電流ループ: MOSFET、ダイオード、出力コンデンサ、電流検出抵抗を含むループを最小にする。
- 高dv/dtノード: SWノードは物理的に小さくし、寄生容量と放射を抑える。
- アナログ小信号ノード: RC、FB、COMP、SS、ISNSフィルタはTPS40210近傍に集め、SWノードから離す。
- 電流検出: RIFLT/CIFLTはISNS/GNDピン近傍。MOSFETソースからRSNS、GNDピンへの戻り経路の寄生を小さくする。
- ゲート駆動: GDRVトレースはMOSFETゲートにできるだけ近く、戻り経路も短くする。
- 入力: ACアダプタや配線が長い場合、セラミック入力コンデンサに加えてバルク容量を置く。
- 高電圧クリアランス: TPS40210データシート上の範囲外のため、PCB設計規則と安全要件で別途決める。
- テストポイント: VIN、VOUT、SW、ISNS、COMP、DIS/EN、GNDを初回評価で測れるようにする。

## 9. 保護・異常時動作

| 機能 | 動作条件 | 関連ピン・端子 | 設計上の意味 | 参照箇所 |
| --- | --- | --- | --- | --- |
| UVLO | VDDがUVLO未満 | VDD | 12 V入力では通常問題ないが、入力立ち上がり中の起動電流に注意。 | p.5, 6.5; p.24, 7.4.1 |
| DIS/EN停止 | DIS/ENをしきい値以上へ駆動 | DIS/EN, BP | 高電圧停止制御に使える。停止時はBPも停止。 | p.15, 7.3.3; p.24, 7.4.2 |
| 過電流ヒカップ | ISNSがVISNS(oc)を超える | ISNS, SS | SSコンデンサ放電後に再試行。CSSが再試行周期にも影響。 | p.18-p.20, 7.3.7 |
| ソフトスタート | 起動時、DIS/EN復帰時、UVLO復帰時 | SS, FB, COMP | 起動時オーバーシュートと過電流を抑える。 | p.12-p.14, 7.3.1 |
| 出力短絡 | 標準昇圧回路の出力短絡 | インダクタ、ダイオード、入力源 | TPS40210だけでは入力から出力への直通経路を遮断できない。今回BOMでは入力側FHV1を追加し、持続短絡時の二次保護とする。 | p.19, 7.3.7 |
| ESD | 取扱い、実装時 | 全端子 | HBM/CDM耐量はあるが通常のESD管理が必要。 | p.4, 6.2; p.41, 11.7 |

## 10. 今回のBOM・回路定数への影響

| 採用候補・設計値 | 用途 | データシート要求 | 判定 | コメント |
| --- | --- | --- | --- | --- |
| TPS40210DGQR | 昇圧コントローラ | VDD 4.5 Vから52 V、外付け低側Nch MOSFET | OK | 12 V入力で使用可。VDDを170 Vへ接続しないこと。 |
| RRC1 ERJ-6ENF1004V + CRC1 100 pF | 発振周波数 | RT 100 kOhmから1 MOhm、CT 68 pFから120 pF推奨 | OK | 約168 kHz。RRCは推奨上限のため、量産前に周波数実測。 |
| L1 7447709102 | 昇圧インダクタ | 通常ピーク電流と過電流時ピークに耐えること | 要確認 | L1は維持。通常ILpeakは約0.35 Aで余裕。RSNS=0.15 Ohmでピーク検出は約0.8 Aから1.2 Aへ低下するが、最大側はIsat 1 Aを超え得るため実測確認。 |
| RSNS1 ERJ-8BSFR15V 0.15 Ohm | MOSFETソース電流検出 | VISNS(oc)とEq.19の両方を満たす | OK/要実測 | Eq.19の80 %目安約0.151 Ohm内。VIN=10.8 Vでの出力過電流目安は約49 mA / 61 mA / 74 mA。通常損失は約15 mWで0.5 W定格に余裕。 |
| RIFLT1 ERJ-3GEYJ102V 1 kOhm + CIFLT1 470 pF | ISNSフィルタ | RIFLT x CIFLT = 0.1 x tON | OK/要実測 | 今回条件では目安約0.55 us。採用値は0.47 us。RIFLTはPanasonic在庫品の5 %品で、時定数ばらつき込みで実機確認する。 |
| CSS1 1 uF | ソフトスタート | COUT充電電流 + 起動時負荷電流が過電流点未満 | OK/要実測 | tSSは約32 msから60 ms。20 mA負荷付き起動でも最小側過電流点に対して余裕を持つ見込み。 |
| CIN1, CIN2 10 uF / 25 V x2 + CINB1, CINB2 22 uF / 25 V x2 | 入力平滑 | 入力リップル、入力源距離に応じた容量 | OK/要実測 | CIN計算上は十分。ACアダプタ配線と起動電流を見込み、Murata MLCCの入力バルクを追加。DCバイアス後実容量とVINリップルは実測。 |
| COUT1-COUT3 1 uF / 250 V x3 | 出力平滑 | 出力リップルと実効容量 | OK/要実測 | nominalでは十分。170 V DCバイアス時の実効容量とリップルはMurataデータまたは実測で確認。 |
| CBP1 1 uF / 25 V | BPバイパス | BP-GND間に1 uF | OK | 必ずU1近傍。 |
| CVDD1 1 uF / 25 V | VDDバイパス | VDD-GND間の近接バイパス | OK | U1近傍。高周波用に0.1 uF併設も実装上は検討余地あり。 |
| RFB1-RFB5 20 kOhm x5, RFB6 412 Ohm | FB分圧 | 上側抵抗10 kOhmから100 kOhm目安 | OK | 出力typ約170.6 V。上側合計100 kOhmで目安上限。電圧分担、損失、沿面距離を確認。 |
| RCOMP1 68 kOhm, CCOMP1 2200 pF, CHF1 47 pF | 補償 | ループ帯域はfSWの20 %以下、10 %程度が現実的 | OK/要実測 | 初期値として妥当。ダイナミック点灯負荷でCOMP/SW/VOUT応答を確認。 |
| RG1 10.2 Ohm | MOSFETゲート抵抗 | RG = 105 / QGが開始点 | 要確認 | MOSFET QGがTPS40210 PDFでは分からない。現状はEMI寄りの保守値として扱い、発熱と波形で調整。 |
| Q1 STD10N60M2 | 昇圧MOSFET | 外付けMOSFETは電圧、電流、QG、損失に耐えること | OK/要実測 | 600 V耐圧は十分。QGとスイッチング損失はMOSFETデータシートで確認。 |
| D1 STTH2R06U | 昇圧整流 | VBR >= VOUT / 0.8、電流と損失に耐えること | OK/要実測 | 600 V / 2 A / trr 50 nsで、現行要求に対し耐圧と電流余裕を持つ。逆回復、順方向損失、温度はダイオードデータシートと実測で確認。 |
| REN1 1 kOhm, RENPD1 100 kOhm | DIS/EN制御 | DIS/ENは高で停止、低または未接続で有効 | OK | MCU側のHV_ENABLE論理は「Highで停止」または外部反転を明記する。 |
| RBLD1-RBLD3 1.1 MOhm x3 | 出力放電 | TPS40210上の直接指定なし | OK/要実測 | 3 uF nominalなら時定数約9.9 s。実効容量と安全電圧到達時間を実測。 |
| FHV1 0437.750KRA | 12 V入力側ヒューズ | TPS40210単体で遮断できない短絡電流経路の二次保護 | OK/要実測 | 通常入力電流は概ね0.4 A以下の想定。750 mA fast acting品を採用し、起動突入、短絡時温度、溶断時間を実測確認する。 |

## 11. 既存ドキュメントとBOMの整合メモ

- `docs/tps40210_power_parts_selection.md` と `bom/nixie_clock_integrated_digikey_bom_active.csv` は、CIFLT1 = 470 pF、CSS1 = 1 uF、RSNS1 = 0.15 Ohm、入力バルク CINB1/CINB2、入力ヒューズ FHV1 を反映済み。
- コンデンサは Murata 品、抵抗は Panasonic 品へ揃えた。RIFLT1/REN1はPanasonicの1 kOhm 1 %品がDigi-Key在庫0のため、用途上許容できる5 %品 `ERJ-3GEYJ102V` を採用した。
- 上記変更後もTPS40210データシート観点では初期試作に進められる。ただし、L1の異常時飽和余裕、FHV1の時間電流特性、CINB追加後の起動突入は実機確認が必要。

## 12. 実機検証チェックリスト

### 共通

- [ ] 10.8 V、12.0 V、13.2 VでVDDが推奨範囲内にある。
- [ ] VDD、RC、SS、FB、DIS/EN、ISNS、COMP、BP、GDRVが絶対最大定格を超えない。
- [ ] U1近傍にVDD/BPバイパスが配置されている。
- [ ] TPS40210、MOSFET、ダイオード、インダクタ、電流検出抵抗の温度が許容範囲内。

### 電源回路

- [ ] 無負荷で170 Vに立ち上がる。
- [ ] ダミーロードで170 V / 20 mAが安定する。
- [ ] 起動時にISNSが過電流しきい値へ達しない。
- [ ] 20 mA負荷を起動時から接続した条件でヒカップしない。
- [ ] 実運用のHV安定後に表示負荷を有効化するシーケンスでも再起動時にソフトスタートする。
- [ ] SWノードのオフ時間が最小オフ時間に対して余裕を持つ。
- [ ] ISNS波形に過大なスパイクがなく、RIFLT/CIFLT値が妥当。
- [ ] 出力リップルが許容範囲内。
- [ ] COMP波形に低周波発振や過大なハンチングがない。
- [ ] DIS/ENで高電圧電源が停止し、再有効化時にソフトスタートする。
- [ ] 電源断後、高電圧が放電抵抗で安全側へ下がる。

### 保護

- [ ] FHV1の通常起動時突入電流と時間電流特性が問題ない。
- [ ] 出力短絡時にFHV1が入力源、L1、D1を許容範囲内に保護できる。
- [ ] L1の飽和電流が通常動作だけでなく過電流しきい値に対しても妥当か確認する。

## 13. 未確認事項・追加調査

| 項目 | なぜ未確認か | 次に確認する方法 |
| --- | --- | --- |
| 7447709102の飽和電流と温度上昇 | TPS40210データシートには外付けインダクタの詳細特性がない | WürthデータシートでIsat条件、温度上昇電流、DCR温度係数を確認。過電流設定と照合。 |
| STD10N60M2のQG、Coss、スイッチング損失 | TPS40210データシートには選定MOSFETの特性がない | MOSFETデータシートでVGS=8 V近傍のQGを確認し、RGと温度を実測。 |
| STTH2R06Uの逆回復、順方向損失、温度 | TPS40210データシートには選定ダイオードのtrr/熱特性がない | ダイオードデータシートとSW波形で確認。 |
| GRM55DR72E105KW01Lの170 V時実効容量 | MLCCのDCバイアス特性はTPS40210データシート外 | Murata SimSurfまたは実測で容量低下を確認。 |
| FB/放電抵抗の電圧定格と沿面距離 | 抵抗シリーズデータシートとPCBレイアウト依存 | Panasonicデータシート、PCBルール、実装間隔で確認。 |
| 入力バルクコンデンサ | ACアダプタ配線長、入力保護回路、実PCB配置に依存 | CINB1/CINB2追加後の入力リップル、起動突入、MLCC実効容量を初回基板で確認する。 |
| FHV1の時間電流特性 | TPS40210データシート外で、実際の突入電流と短絡電流に依存 | 通常起動、20 mA負荷付き起動、出力短絡試験でヒューズ温度と溶断挙動を確認する。 |
| 補償値の最終妥当性 | データシート式は初期値であり、負荷特性とレイアウトに依存 | ダミーロード、ダイナミック点灯、CAN途絶停止/復帰で波形確認。可能ならループ測定。 |

## 14. 短い結論

- 今回の指定に従い、`CIFLT1` は470 pF、`CSS1` は1 uF、`RSNS1` は0.15 Ohmへ更新した。
- 入力バルクとして Murata 22 uF / 25 V x2、簡易短絡保護として 12 V入力側ヒューズ `FHV1` を追加し、`D1` は安全寄りに `STTH2R06U` へ置換した。
- 残る主な確認事項は、L1の異常時飽和余裕、FHV1の突入・短絡時挙動、CINB追加後の入力リップル、20 mA負荷付き起動波形である。
