andmatcha/nixie_bom/kicad/nixie_clock/nixie_clock.kicad_sch

## KiCad design kicad/nixie_clock/nixie_clock.kicad_sch (2026-06-24, an earlier design)

Schematic: nixie_clock.kicad_sch

Parts:
C3V3HF1: 0.1uF; C_0603_1608Metric; Manufacturer Part Number GRM188R72A104KA35D; Digi-Key Part Number 490-3285-1-ND
C3V3IN1, C3V3IN2: 4.7uF; C_1206_3216Metric; Manufacturer Part Number GRJ31CR71H475KE11K; Digi-Key Part Number 490-GRJ31CR71H475KE11KCT-ND
C3V3OUT1, C3V3OUT2: 22UF; C_1206_3216Metric; Manufacturer Part Number GRM31CC81E226KE11L; Digi-Key Part Number 490-14468-1-ND
CBOOT1: 0.1uF; C_0603_1608Metric; Manufacturer Part Number GRM188R72A104KA35D; Digi-Key Part Number 490-3285-1-ND
CBP1: 1uF; C_0603_1608Metric; Manufacturer Part Number GCM188R71E105KA64D; Digi-Key Part Number 490-10673-1-ND
CCOMP1: 2200pF; C_0603_1608Metric; Manufacturer Part Number GRM1885C1H222JA01D; Digi-Key Part Number 490-1459-1-ND
CDEC1, CDEC2, CDEC3, CDEC4, CDEC5, CDEC6, CDEC7, CDEC8: 0.1uF; C_0603_1608Metric; Manufacturer Part Number GRM188R72A104KA35D; Digi-Key Part Number 490-3285-1-ND
CHF1: 47PF; C_0603_1608Metric; Manufacturer Part Number GCM1885C1H470GA16J; Digi-Key Part Number 490-GCM1885C1H470GA16JCT-ND
CIFLT1: 470PF; C_0603_1608Metric; Manufacturer Part Number GCM1885C1H471JA16D; Digi-Key Part Number 490-4965-1-ND
CIN1, CIN2: 10uF; C_1206_3216Metric; Manufacturer Part Number GRM31CR71E106KA12K; Digi-Key Part Number 490-14678-1-ND
CINB1, CINB2: 22uF; C_1210_3225Metric; Manufacturer Part Number GRM32ER71E226KE15L; Digi-Key Part Number 490-5313-1-ND
COUT1, COUT2, COUT3: 1uF; C_2220_5750Metric; Manufacturer Part Number GRM55DR72E105KW01L; Digi-Key Part Number 490-3550-1-ND
CRC1: 100PF; C_0603_1608Metric; Manufacturer Part Number GCM1885C1H101JA16D; Digi-Key Part Number 490-4767-1-ND
CSS1: 1uF; C_0603_1608Metric; Manufacturer Part Number GCM188R71E105KA64D; Digi-Key Part Number 490-10673-1-ND
CVDD1: 1uF; C_0603_1608Metric; Manufacturer Part Number GCM188R71E105KA64D; Digi-Key Part Number 490-10673-1-ND
CVPRE1: 0.1uF; C_1206_3216Metric; Manufacturer Part Number GRM31CR72E104KW03L; Digi-Key Part Number 490-3542-1-ND
CY1, CY2: 18PF; C_0603_1608Metric; Manufacturer Part Number GCM1885C1H180FA16D; Digi-Key Part Number 490-GCM1885C1H180FA16DCT-ND
D1: STTH2R06U; D_SMB; Manufacturer Part Number STTH2R06U; Digi-Key Part Number 497-3776-1-ND
D2: ESD2CAN24DBZRQ1; SOT-23-3; Manufacturer Part Number ESD2CAN24DBZRQ1; Digi-Key Part Number 296-ESD2CAN24DBZRQ1CT-ND
FHV1: 750mA; Fuse_1206_3216Metric; Manufacturer Part Number 0437.750KRA; Digi-Key Part Number 18-0437.750KRACT-ND
JCAN1: CAN; OnShore_OSTVN03A150_1x03_P2.54mm_Horizontal; Manufacturer Part Number OSTVN03A150; Digi-Key Part Number ED10562-ND
JSWD1: SWD; Samtec_FTSH_105_01_F_DV_K_2x05_P1.27mm_Vertical_SMD; Manufacturer Part Number FTSH-105-01-F-DV-K; Digi-Key Part Number SAM8796-ND
L1: 1mH; L_Wuerth_WE-PD-Typ-M-Typ-S; Manufacturer Part Number 7447709102; Digi-Key Part Number 732-1702-1-ND
L2: 6.8uH; L_Wuerth_XHMI-6060; Manufacturer Part Number 74439346068; Digi-Key Part Number 732-10705-1-ND
Q1: STD10N60M2; TO-252-3_TabPin4; Manufacturer Part Number STD10N60M2; Digi-Key Part Number 497-13937-1-ND
QAH1, QAH2, QAH3, QAH4, QAH5, QAH6: MMBTA92-7-F; SOT-23; Manufacturer Part Number MMBTA92-7-F; Digi-Key Part Number MMBTA92-FDICT-ND
QAL1, QAL2, QAL3, QAL4, QAL5, QAL6: MMBTA42-7-F; SOT-23; Manufacturer Part Number MMBTA42-7-F; Digi-Key Part Number MMBTA42-FDICT-ND
QCOL1, QCOL2, QCOL3, QCOL4: MMBTA42-7-F; SOT-23; Manufacturer Part Number MMBTA42-7-F; Digi-Key Part Number MMBTA42-FDICT-ND
R3V3EN1: 100kOhm; R_0603_1608Metric; Manufacturer Part Number ERJ-3EKF1003V; Digi-Key Part Number P100KHCT-ND
RA1, RA2, RA3, RA4, RA5, RA6: 2.2kOhm; R_1206_3216Metric; Manufacturer Part Number ERJ-P08F2201V; Digi-Key Part Number 10-ERJ-P08F2201VCT-ND
RAHDRV1A, RAHDRV1B, RAHDRV2A, RAHDRV2B, RAHDRV3A, RAHDRV3B, RAHDRV4A, RAHDRV4B, RAHDRV5A, RAHDRV5B, RAHDRV6A, RAHDRV6B: 220kOhm; R_0805_2012Metric; Manufacturer Part Number ERJ-6ENF2203V; Digi-Key Part Number P220KCCT-ND
RAHOFF1A, RAHOFF1B, RAHOFF2A, RAHOFF2B, RAHOFF3A, RAHOFF3B, RAHOFF4A, RAHOFF4B, RAHOFF5A, RAHOFF5B, RAHOFF6A, RAHOFF6B: 499kOhm; R_0805_2012Metric; Manufacturer Part Number ERJ-6ENF4993V; Digi-Key Part Number P499KCCT-ND
RALB1, RALB2, RALB3, RALB4, RALB5, RALB6: 10kOhm; R_0603_1608Metric; Manufacturer Part Number ERJ-3EKF1002V; Digi-Key Part Number P10.0KHCT-ND
RALPD1, RALPD2, RALPD3, RALPD4, RALPD5, RALPD6: 100kOhm; R_0603_1608Metric; Manufacturer Part Number ERJ-3EKF1003V; Digi-Key Part Number P100KHCT-ND
RBLD1, RBLD2, RBLD3: 1.1MOhm; R_0805_2012Metric; Manufacturer Part Number ERJ-6ENF1104V; Digi-Key Part Number P1.10MCCT-ND
RBOOT1: 100kOhm; R_0603_1608Metric; Manufacturer Part Number ERJ-3EKF1003V; Digi-Key Part Number P100KHCT-ND
RCANSHDN1: 100kOhm; R_0603_1608Metric; Manufacturer Part Number ERJ-3EKF1003V; Digi-Key Part Number P100KHCT-ND
RCANSTB1: 100kOhm; R_0603_1608Metric; Manufacturer Part Number ERJ-3EKF1003V; Digi-Key Part Number P100KHCT-ND
RCOLB1, RCOLB2, RCOLB3, RCOLB4: 10kOhm; R_0603_1608Metric; Manufacturer Part Number ERJ-3EKF1002V; Digi-Key Part Number P10.0KHCT-ND
RCOLPD1, RCOLPD2, RCOLPD3, RCOLPD4: 100kOhm; R_0603_1608Metric; Manufacturer Part Number ERJ-3EKF1003V; Digi-Key Part Number P100KHCT-ND
RCOMP1: 68kOhm; R_0805_2012Metric; Manufacturer Part Number ERJ-6ENF6802V; Digi-Key Part Number P68.0KCCT-ND
REN1: 1KOHM; R_0603_1608Metric; Manufacturer Part Number ERJ-3GEYJ102V; Digi-Key Part Number P1.0KGCT-ND
RENPD1: 100kOhm; R_0603_1608Metric; Manufacturer Part Number ERJ-3EKF1003V; Digi-Key Part Number P100KHCT-ND
RFB1, RFB2, RFB3, RFB4, RFB5: 20kOhm; R_0805_2012Metric; Manufacturer Part Number ERJ-6ENF2002V; Digi-Key Part Number P20.0KCCT-ND
RFB6: 412Ohm; R_0805_2012Metric; Manufacturer Part Number ERJ-6ENF4120V; Digi-Key Part Number P412CCT-ND
RG1: 10.2Ohm; R_0603_1608Metric; Manufacturer Part Number ERJ-3EKF10R2V; Digi-Key Part Number P10.2HCT-ND
RIFLT1: 1KOHM; R_0603_1608Metric; Manufacturer Part Number ERJ-3GEYJ102V; Digi-Key Part Number P1.0KGCT-ND
RINS1, RINS2, RINS3, RINS4: 180kOhm; R_1206_3216Metric; Manufacturer Part Number ERJ-P08F1803V; Digi-Key Part Number 10-ERJ-P08F1803VCT-ND
RKP1, RKP2, RKP3, RKP4, RKP5, RKP6, RKP7, RKP8, RKP9, RKP10: 1MOhm; R_0805_2012Metric; Manufacturer Part Number ERJ-6ENF1004V; Digi-Key Part Number P1.00MCCT-ND
RNRST1: 10kOhm; R_0603_1608Metric; Manufacturer Part Number ERJ-3EKF1002V; Digi-Key Part Number P10.0KHCT-ND
ROE1: 100kOhm; R_0603_1608Metric; Manufacturer Part Number ERJ-3EKF1003V; Digi-Key Part Number P100KHCT-ND
RPREH1: 180kOhm; R_0805_2012Metric; Manufacturer Part Number ERJ-6ENF1803V; Digi-Key Part Number P180KCCT-ND
RPREL1: 180kOhm; R_0805_2012Metric; Manufacturer Part Number ERJ-6ENF1803V; Digi-Key Part Number P180KCCT-ND
RRC1: 1MOhm; R_0805_2012Metric; Manufacturer Part Number ERJ-6ENF1004V; Digi-Key Part Number P1.00MCCT-ND
RSNS1: 0.15Ohm; R_1206_3216Metric; Manufacturer Part Number ERJ-8BSFR15V; Digi-Key Part Number 10-ERJ-8BSFR15VCT-ND
RSRCLR1: 10kOhm; R_0603_1608Metric; Manufacturer Part Number ERJ-3EKF1002V; Digi-Key Part Number P10.0KHCT-ND
RT1: 120Ohm; R_0603_1608Metric; Manufacturer Part Number ERJ-3EKF1200V; Digi-Key Part Number P120HCT-ND
U1: TPS40210DGQR; HVSSOP-10-1EP_3x3mm_P0.5mm_EP1.83x1.89mm; Manufacturer Part Number TPS40210DGQR; Digi-Key Part Number 296-26969-1-ND
U2: STM32G0B1CBT6; LQFP-48_7x7mm_P0.5mm; Manufacturer Part Number STM32G0B1CBT6; Digi-Key Part Number 497-STM32G0B1CBT6-ND
U3: AP63203QWU-7; TSOT-23-6; Manufacturer Part Number AP63203QWU-7; Digi-Key Part Number 31-AP63203QWU-7CT-ND
U4: TCAN334GDR; SOIC-8_3.9x4.9mm_P1.27mm; Manufacturer Part Number TCAN334GDR; Digi-Key Part Number 296-49940-1-ND
U5, U6, U7: SN74HC595DR; SOIC-16_3.9x9.9mm_P1.27mm; Manufacturer Part Number SN74HC595DR; Digi-Key Part Number 296-14857-1-ND
U8, U9: SN75468DR; SOIC-16_3.9x9.9mm_P1.27mm; Manufacturer Part Number SN75468DR; Digi-Key Part Number 296-26653-1-ND
XIN1P1, XIN1P2, XIN1P3, XIN1P4, XIN1P5, XIN1P6, XIN1P7, XIN1P8, XIN1P9, XIN1P10, XIN1P11, XIN1P12, XIN2P1, XIN2P2, XIN2P3, XIN2P4, XIN2P5, XIN2P6, XIN2P7, XIN2P8, XIN2P9, XIN2P10, XIN2P11, XIN2P12, XIN3P1, XIN3P2, XIN3P3, XIN3P4, XIN3P5, XIN3P6, XIN3P7, XIN3P8, XIN3P9, XIN3P10, XIN3P11, XIN3P12, XIN4P1, XIN4P2, XIN4P3, XIN4P4, XIN4P5, XIN4P6, XIN4P7, XIN4P8, XIN4P9, XIN4P10, XIN4P11, XIN4P12, XIN5P1, XIN5P2, XIN5P3, XIN5P4, XIN5P5, XIN5P6, XIN5P7, XIN5P8, XIN5P9, XIN5P10, XIN5P11, XIN5P12, XIN6P1, XIN6P2, XIN6P3, XIN6P4, XIN6P5, XIN6P6, XIN6P7, XIN6P8, XIN6P9, XIN6P10, XIN6P11, XIN6P12: IN-12 socket pin; MillMax_9353_1_15_80_18_27_10_0; Manufacturer Part Number 9353-1-15-80-18-27-10-0; Digi-Key Part Number 54-9353-1-15-80-18-27-10-0-ND
Y1: 8MHz; Crystal_SMD_3225-4Pin_3.2x2.5mm; Manufacturer Part Number ECS-80-12-33-JGN-TR; Digi-Key Part Number 50-ECS-80-12-33-JGN-CT-ND
