andmatcha/nixie_bom/(commit log)

2026-06-22 documents and python programs
    [nixie_clock_integrated_digikey_bom_active.csv]
2026-06-22 TPS40210電源部品の選定根拠を更新
2026-06-22 アクティブBOMとDigi-Key集計を更新
    [nixie_clock_active_digikey_availability.csv, nixie_clock_active_digikey_price_list.csv, nixie_clock_integrated_digikey_bom_active.csv]
2026-06-22 作業ログとエディタ設定を追跡対象外にする
2026-06-22 ニキシー管駆動部品のBOMを更新
    [nixie_clock_active_digikey_availability.csv, nixie_clock_active_digikey_price_list.csv, nixie_clock_integrated_digikey_bom_active.csv]
2026-06-22 Digi-Key BOM管理をdktoolsへ移行
    [bom.csv]
2026-06-22 BOM部品の最新情報を取得
2026-06-22 IN-12データシートとソケット接点を追加
    [bom.csv]
2026-06-23 KiCadプロジェクト管理設定を追加
2026-06-23 BOMからKiCad配置プロジェクトを生成
    [nixie_clock.kicad_sch, pins.csv]
2026-06-23 KiCad回路図に標準シンボル定義を埋め込む
    [nixie_clock.kicad_sch]
2026-06-23 KiCadのローカル生成物を無視
2026-06-23 KiCadフットプリントを確定して監査を追加
    [nixie_clock.kicad_sch]
2026-06-23 KiCad PCBへフットプリントを配置
    [nixie_clock.kicad_pcb]
2026-06-23 KiCadプロジェクト設定を保存
2026-06-23 KiCad回路図を機能ブロックで整理
    [nixie_clock.kicad_sch]
2026-06-24 電源回路図をワイヤ配線で整理
    [nixie_clock.kicad_sch]
